buteomont/mqttListener/pictures/breadboard.jpg

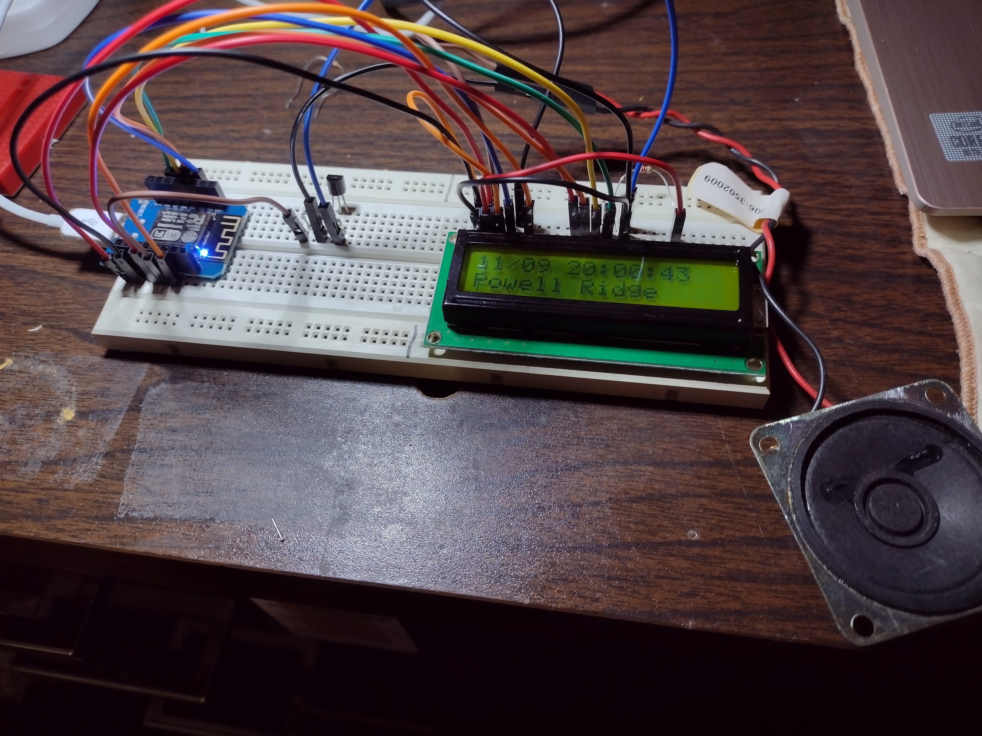
pictures/breadboard.jpg
