buteomont/mqttListener/presentation/listener.jpg

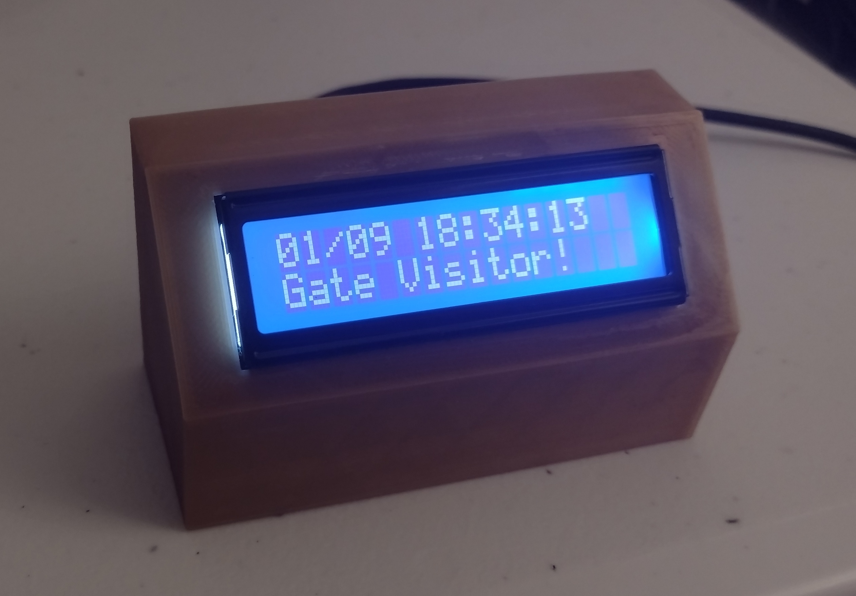
presentation/listener.jpg
