buteomont/mqttListener/hardware/mqttListener.png

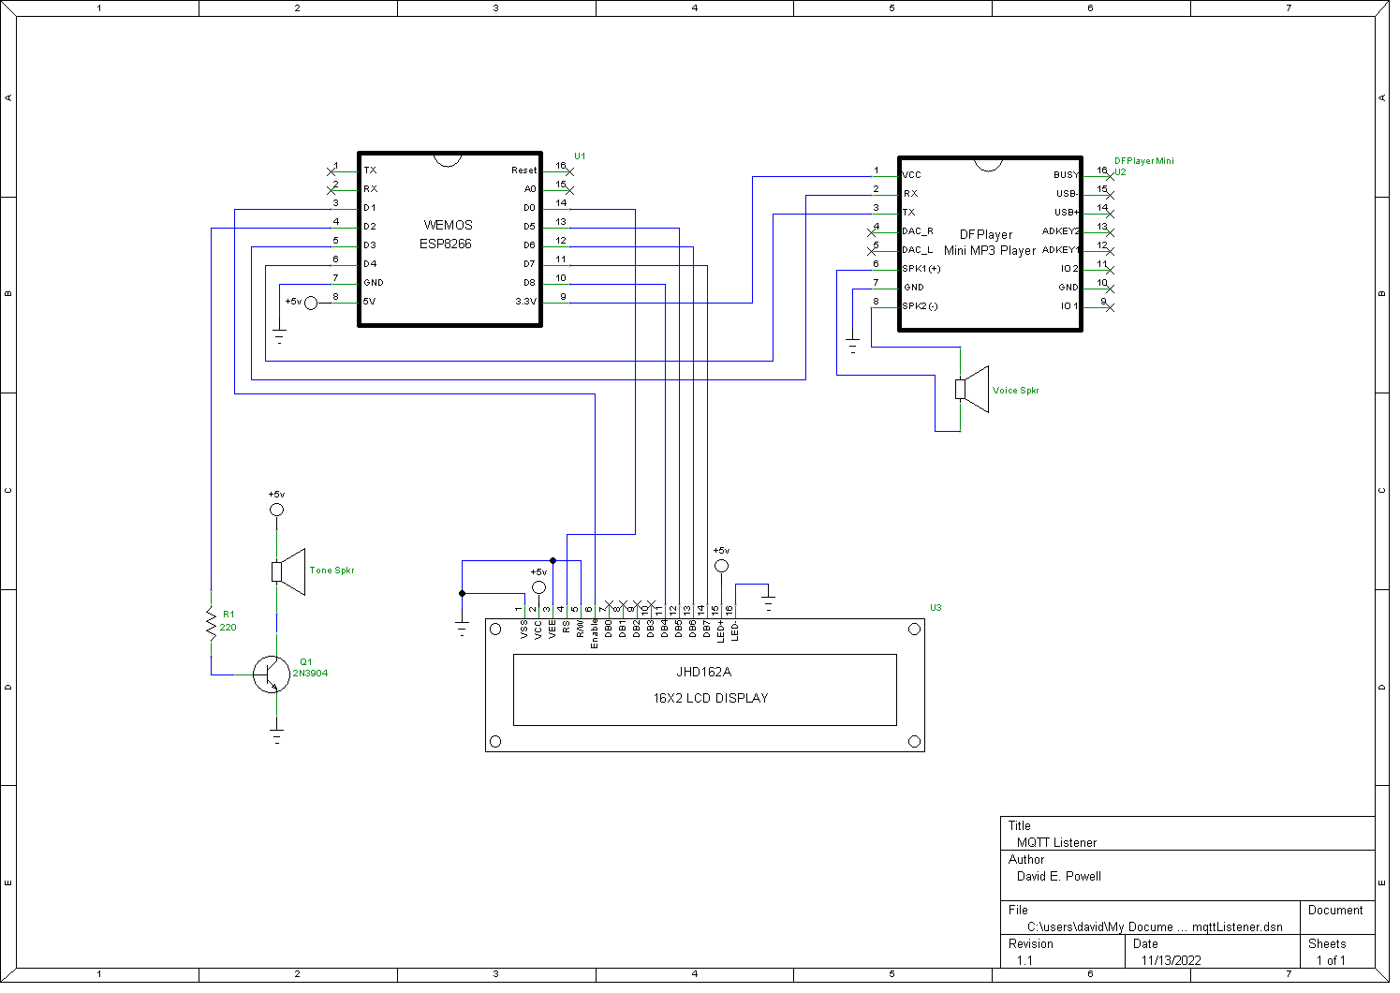
hardware/mqttListener.png
