buteomont/mqttListener/presentation/DFPlayer_Mini.png

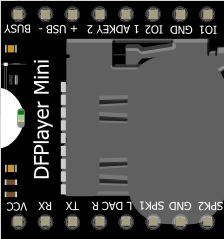
presentation/DFPlayer_Mini.png
