buteomont/mqttListener/presentation/ESP8266.png

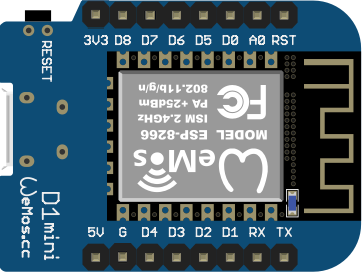
presentation/ESP8266.png
