buteomont/mqttListener/(list of files, drawings)

Other design files:
hardware/mqttListener.dsn
