buteomont/mqttListener/(commit log)

2021-12-16 Fixed defective serial configuration routine
    [main.cpp]
2022-11-19 Added MP3 player and removed beep circuit
    [mqttListener.dsn]
2022-11-20 Added sound and case files to source control
    [mqttListener with display.scad]
2022-11-21 fixed error which ignored "settings" command
    [main.cpp]
2022-11-28 Couple of bug fixes
    [main.cpp]
2023-01-10 Created presentation
    [mqttListener.dsn]
2023-01-24 bug: not displaying message3 properly in settings
    [main.cpp]
2023-04-14 Added carriage return to history entries
2023-05-03 MQTT PubSub message buffer was too small
    [main.cpp, mqttListener.h]
